oskar2517/numitron-clock/BOM_LCSC.xls

Numitron Clock |  |  |  |  |  |  |  |  |  | LCSC BOM Quotation
 |  |  |  |  |  |  |  |  |  | BOM Date Created：03/09/25 05:54:36 |  |  |  | BOM Export Date: 03/09/25 06:03:54 |  |  |  | The matching result is a real-time query result, availability and prices may fluctuate. Backorder items are estimated prices for your reference, please submit "Create Quote" to get the real price. All information is provided "as is" and is subject to change without notice. Any use made of the information provided is without recourse to LCSC and at the user's risk.
 |  |  |  |  |  |  |  |  |  | EST TOTAL :$13.57 |  |  |  | Website：https://www.lcsc.com/bom | https://www.lcsc.com/bom | https://www.lcsc.com/bom | https://www.lcsc.com/bom
Uploaded data |  |  |  |  |  |  |  |  |  | LCSC Matching Results
LCSC# | Mfr. | Mrf# | Description | Package | Value | Customer Part Number | Quantity | Target Price(EUR) | Target Lead Time(Business Days) | Mrf# | Mfr. | Order Qty. | Unit Price(EUR) | Ext.Price(EUR) | LCSC# | Package | Min | Mult | SPQ | Availability | Stock Status | Customer Notes | Description | Matched status | Product Link
 |  |  |  |  |  |  | 1 |  |  | -(The data has been deleted.) | - | - | - | - | - | - | - | - | - | - | - | - | - | - | https://uat.lcsc.com/product-detail/schottky-barrier-diodes-sbd_lge-10mq040n_C688893.html
 |  |  |  |  |  |  | 1 |  |  | -(The data has been deleted.) | - | - | - | - | - | - | - | - | - | - | - | - | - | -
 |  |  |  |  |  |  | 1 |  |  | BS-02-A1AK006 | MYOUNG | 5 | 0.1719 | 0.86 | C964746 | Through Hole | 5 | 5 | 300 | 16845 | In Stock |  | Battery Holder Tin -25℃~+85℃ Phosphor Bronze CR2032 Through Hole Button And Strip Battery Connector ROHS | Exact Matches | https://www.lcsc.com/product-detail/C964746.html
 |  |  |  |  |  |  | 1 |  |  | TYPE-C-31-M-33 | Korean Hroparts Elec | 5 | 0.1243 | 0.62 | C2848624 | Through Hole | 5 | 5 | 50 | 4570 | In Stock |  | 3A 1 Right Angle 2P Female -30℃~+80℃ Type-C Through Hole USB Connectors ROHS | Exact Matches | https://www.lcsc.com/product-detail/C2848624.html
 |  |  |  |  |  |  | 1 |  |  | CC1H104ZA1ED3F5O1100 | Dersonic | 50 | 0.0104 | 0.52 | C2761728 | Through Hole,P=2.54mm | 50 | 50 | 1000 | 22700 | In Stock |  | -20%~+80% 100nF Y5V 50V Through Hole,P=2.54mm Through Hole Ceramic Capacitors ROHS | Exact Matches | https://www.lcsc.com/product-detail/C2761728.html
 |  |  |  |  |  |  | 1 |  |  | 1N5817 | LGE | 20 | 0.0286 | 0.57 | C7544876 | DO-41 | 20 | 20 | 5000 | 10660 | In Stock |  | 20V Independent 1A 450mV@1A DO-41 Schottky Diodes ROHS | Exact Matches | https://www.lcsc.com/product-detail/C7544876.html
 |  |  |  |  |  |  | 1 |  |  | X206032768KGB2SC | YXC Crystal Oscillators | 10 | 0.0508 | 0.51 | C2236 | DT-26 | 10 | 10 | 1000 | 279140 | In Stock |  | 32.768kHz Through Hole Crystal Oscillator 12.5pF ±10ppm ±20ppm DT-26 Crystals ROHS | Exact Matches | https://www.lcsc.com/product-detail/C2236.html
 |  |  |  |  |  |  | 1 |  |  | MFR-25FBF52-470R | YAGEO | 50 | 0.0155 | 0.78 | C1369905 | Through Hole,D2.4xL6.3mm | 50 | 50 | 1000 | 3750 | In Stock |  | Metal Film Resistor 470Ω 250mW ±100ppm/℃ ±1% Through Hole,D2.4xL6.3mm Through Hole Resistors ROHS | Exact Matches | https://www.lcsc.com/product-detail/C1369905.html
 |  |  |  |  |  |  | 1 |  |  | MFR-25FBF52-100R | YAGEO | 50 | 0.0141 | 0.71 | C6300650 | Through Hole,D2.4xL6.3mm | 50 | 50 | 1000 | 6950 | In Stock |  | Metal Film Resistor 100Ω 250mW ±100ppm/℃ ±1% Through Hole,D2.4xL6.3mm Through Hole Resistors ROHS | Exact Matches | https://www.lcsc.com/product-detail/C6300650.html
 |  |  |  |  |  |  | 1 |  |  | MFR-25FTE52-4K7 | YAGEO | 50 | 0.0105 | 0.53 | C173023 | Through Hole,D2.4xL6.3mm | 50 | 50 | 5000 | 36950 | In Stock |  | Metal Film Resistor 4.7kΩ 250mW ±50ppm/℃ ±1% Through Hole,D2.4xL6.3mm Through Hole Resistors ROHS | Exact Matches | https://www.lcsc.com/product-detail/C173023.html
 |  |  |  |  |  |  | 1 |  |  | RD1C106M05011BB180 | SAMWHA | 20 | 0.0319 | 0.64 | C19712069 | Through Hole | 20 | 20 | 500 | 5760 | In Stock |  | 10uF ±20% Through Hole Aluminum Electrolytic Capacitors - Leaded ROHS | Exact Matches | https://www.lcsc.com/product-detail/C19712069.html
 |  |  |  |  |  |  | 1 |  |  | H2541FV-C762-2x09P | HanElectricity | 13 | 0.0388 | 0.50 | C22387109 | DIP-18 | 13 | 13 | 26 | 2860 | In Stock |  | 18P DIP 7.62mm 2.54mm DIP-18 IC / Transistor Socket ROHS | Exact Matches | https://www.lcsc.com/product-detail/C22387109.html
 |  |  |  |  |  |  | 1 |  |  | Z-ICS0S16P-NG00 | Ckmtw | 10 | 0.0506 | 0.51 | C146580 | DIP-16 | 10 | 10 | 30 | 1280 | In Stock |  | 16P DIP Tin 7.62mm 2.54mm DIP-16 IC / Transistor Socket ROHS | Exact Matches | https://www.lcsc.com/product-detail/C146580.html
 |  |  |  |  |  |  | 1 |  |  | DS1009-08AT1NX-0A2 | CONNFLY Elec | 20 | 0.0226 | 0.45 | C72124 | DIP-8 | 20 | 20 | 60 | 58320 | In Stock |  | 8P DIP Tin 7.62mm 2.54mm DIP-8 IC / Transistor Socket ROHS | Exact Matches | https://www.lcsc.com/product-detail/C72124.html
 |  |  |  |  |  |  | 4 |  |  | HT62783ANZ | HTCSEMI | 5 | 0.3006 | 1.50 | C2976650 | DIP-18 | 5 | 5 | 20 | 6055 | In Stock |  | 8 50V 500mA DIP-18 Darlington Transistor Arrays ROHS | Exact Matches | https://www.lcsc.com/product-detail/C2976650.html
 |  |  |  |  |  |  | 4 |  |  | SN74HC595N | TI | 4 | 0.4638 | 1.86 | C78711 | DIP-16 | 1 | 1 | 25 | 160 | In Stock |  | 8 2V~6V 1 Serial-to-Serial or Parallel DIP-16 Shift Registers ROHS | Exact Matches | https://www.lcsc.com/product-detail/C78711.html
 |  |  |  |  |  |  | 1 |  |  | DS1307N+ | MAXIM | 1 | 3.0144 | 3.01 | C1520521 | PDIP-8 | 1 | 1 | 50 | 0 | Backordered |  | I2C PDIP-8 Real Time Clocks ROHS | Exact Matches | https://www.lcsc.com/product-detail/C1520521.html
