oskar2517/numitron-clock/BOM_Numitron-Clock.csv

ID | Name | Designator | Footprint | Quantity | Manufacturer Part | Manufacturer | Supplier | Supplier Part | Price
1 | 4.7k | R65,R66 | R_AXIAL-0.3 | 2
2 | BS-02-A1AK006 | BT1 | BAT-TH_BS-02-A1AK006 | 1 | BS-02-A1AK006 | MYOUNG(美阳) | LCSC | C964746 | 0.195
3 | 100nF | C1,C4,C5,C6,C7,C8,C9,C2,C3,C10 | RAD-0.1 | 10
4 | 1N5817_C256526 | D1 | DO-41_BD2.4-L4.7-P8.70-D0.9-RD | 1 | 1N5817 | GD(固锝) | LCSC | C256526 | 0.027
5 | K4-6×6_TH | KEY1 | KEY-TH_4P-L6.0-W6.0-P4.50-LS6.5 | 1 | K2-1102DP-E4SW-04 | 韩国韩荣 | LCSC | C136684 | 0.042
6 | TBD62783APG | U1,U5,U3,U7 | DIP-18_L23.0-W6.5-P2.54-LS7.6-BL | 4 | TBD62783APG | TOSHIBA(东芝) | LCSC | C146380 | 0.933
7 | 74HC595N | U4,U8,U2,U6 | DIP-16_L20.0-W6.4-P2.54-LS7.6-BL | 4 | 74HC595N | HGSEMI(华冠) | LCSC | C507175 | 0.14
8 | DS1307N+ | U9 | PDIP-8_L9.6-W6.4-P2.54-LS7.6-BL | 1 | DS1307N+ | ADI(亚德诺)/MAXIM(美信) | LCSC | C1520521 | 1.163
9 | TYPE-C-31-M-33 | USB1 | USB-C-TH_TYPE-C-31-M-33 | 1 | TYPE-C-31-M-33 | 韩国韩荣 | LCSC | C2848624 | 0.141
10 | Numitron DR2010 | V1,V2,V3,V4 | NUMITRON_SOCKET | 4 | DR2000 | RCA
11 | 32.768kHz | X1 | OSC-TH_BD2.0-P0.70-D0.3 | 1 | XBMCZLNDND-32.768K | TAITIEN(泰艺电子) | LCSC | C117859 | 0.103
12 | 470 | R1,R2,R3,R4,R5,R6,R7,R8,R33,R34,R35,R36,R37,R38,R39,R40,R17,R18,R19,R20,R21,R22,R23,R24,R49,R50,R51,R52,R53,R54,R55,R56 | R_AXIAL-0.3 | 32
13 | 100 | R32,R63,R64,R9,R10,R11,R12,R13,R14,R15,R16,R25,R26,R27,R28,R29,R30,R31,R41,R42,R43,R44,R45,R46,R47,R48,R57,R58,R59,R60,R61,R62 | R_AXIAL-0.3 | 32
14 | 10uF | C11 | CAP-D5.0×F2.0 | 1
15 | XIAO-ESP32C3 | U11 | XIAO-ESP32C3 | 1 | https://www.seeedstudio.com/Seeed-XIAO-ESP32C3-p-5431.html |  | Digi-Key | 113991054
