oskar2517/numitron-clock/(commit log)

2025-08-31 move tubes count to constant
2025-09-02 lower delay for pin pulsing
2025-09-29 add public files
    [BOM_Numitron-Clock.csv]
2025-09-29 add lcsc bom
    [BOM_LCSC.xls]
